Zachnad0/KICAD-ESP32-ZBoard-Mk-I/KICAD-ESP32-ZBoard-Mk-I.kicad_pcb

## KiCad design KICAD-ESP32-ZBoard-Mk-I.kicad_pcb (2025-09-27)

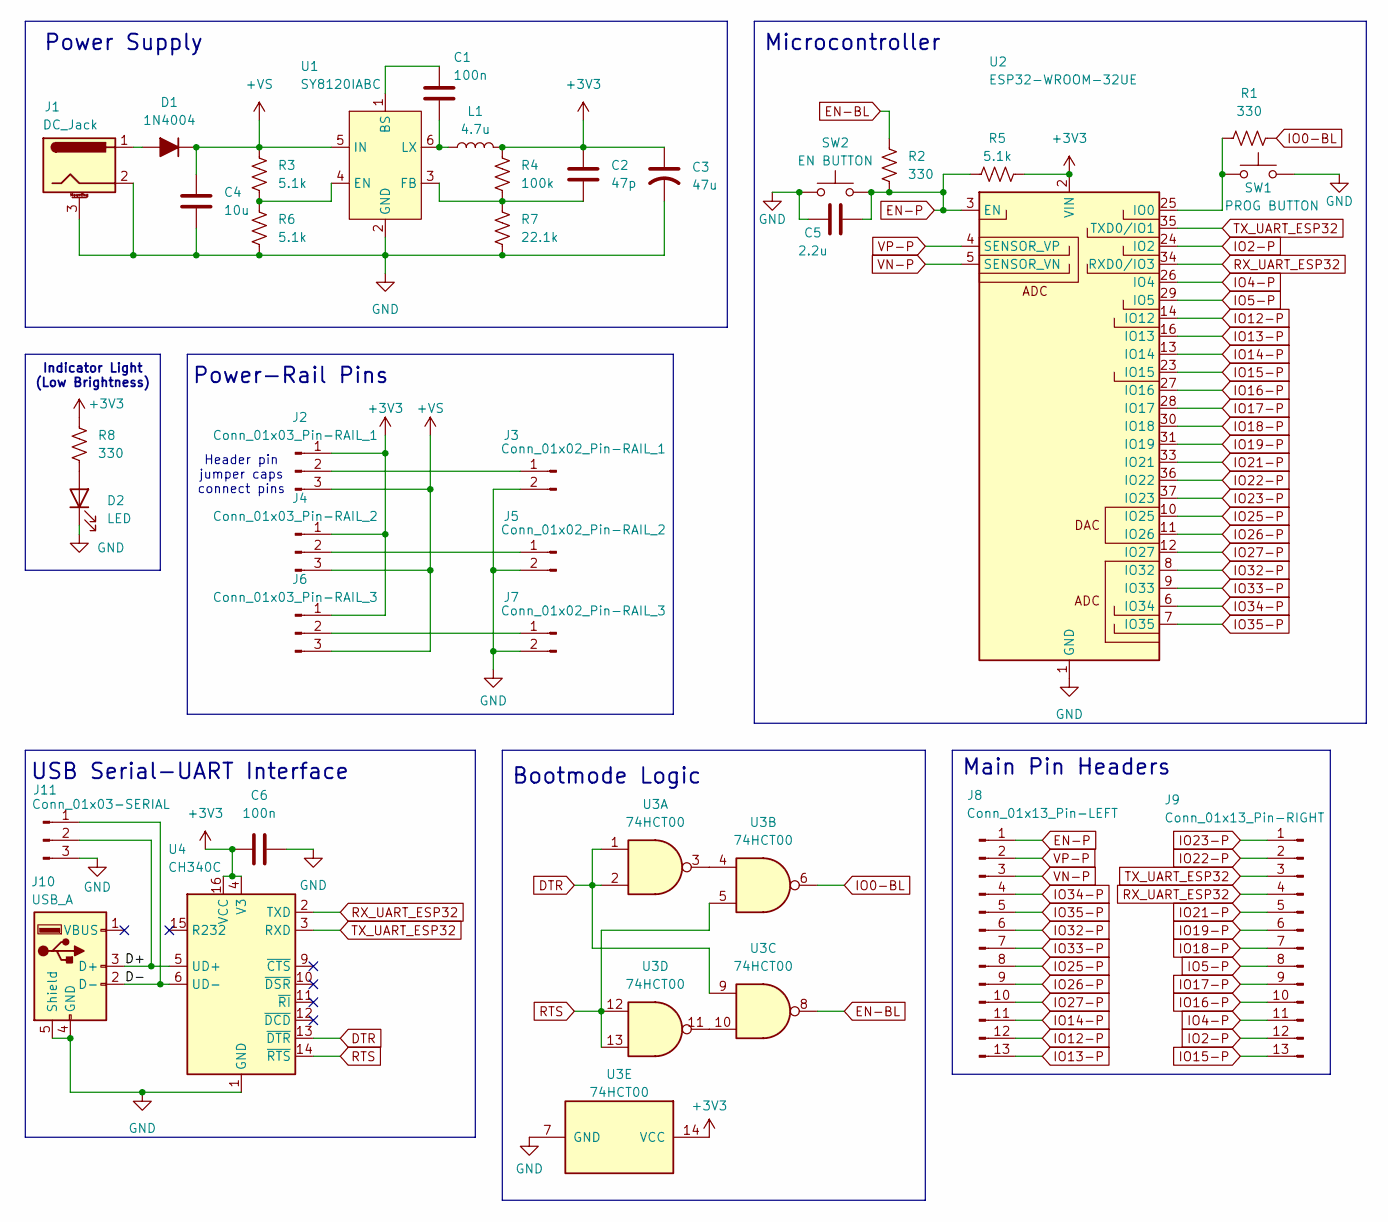
[picture p1: schematic KICAD-ESP32-ZBoard-Mk-I.kicad_sch, ZBoard Mk-I]

Parts:
C1, C6: 100n; C_1206_3216Metric_Pad1.33x1.80mm_HandSolder; LCSC Part # C97946
C2: 47p; C_0603_1608Metric_Pad1.08x0.95mm_HandSolder; LCSC Part # C882552
C3: 47u; CP_Radial_D5.0mm_P2.50mm; LCSC Part # n/a
C4: 10u; C_0805_2012Metric_Pad1.18x1.45mm_HandSolder; LCSC Part # C440198
C5: 2.2u; C_0603_1608Metric_Pad1.08x0.95mm_HandSolder; LCSC Part # C415535
D1: 1N4004; D_DO-41_SOD81_P7.62mm_Horizontal; LCSC Part # n/a
D2: LED; D_0603_1608Metric_Pad1.05x0.95mm_HandSolder; LCSC Part # C497928
J1: DC_Jack; BarrelJack_Horizontal; LCSC Part # C720557
J2: Conn_01x03_Pin-RAIL_1; PinHeader_1x03_P2.54mm_Vertical; LCSC Part # n/a
J3: Conn_01x02_Pin-RAIL_1; PinHeader_1x02_P2.54mm_Vertical; LCSC Part # n/a
J4: Conn_01x03_Pin-RAIL_2; PinHeader_1x03_P2.54mm_Vertical; LCSC Part # n/a
J5: Conn_01x02_Pin-RAIL_2; PinHeader_1x02_P2.54mm_Vertical; LCSC Part # n/a
J6: Conn_01x03_Pin-RAIL_3; PinHeader_1x03_P2.54mm_Vertical; LCSC Part # n/a
J7: Conn_01x02_Pin-RAIL_3; PinHeader_1x02_P2.54mm_Vertical; LCSC Part # n/a
J8: Conn_01x13_Pin-LEFT; PinHeader_1x13_P2.54mm_Vertical; LCSC Part # n/a
J9: Conn_01x13_Pin-RIGHT; PinHeader_1x13_P2.54mm_Vertical; LCSC Part # n/a
J10: USB_A; USB-A Jing (C42576); LCSC Part # C42576
J11: Conn_01x03-SERIAL; PinHeader_1x03_P2.54mm_Vertical
L1: 4.7u; L_TDK_SLF7045; LCSC Part # C136201
R1, R2, R8: 330; R_0603_1608Metric; LCSC Part # C384242
R3, R5, R6: 5.1k; R_0603_1608Metric; LCSC Part # C318133
R4: 100k; R_0603_1608Metric; LCSC Part # C25803
R7: 22.1k; R_0603_1608Metric; LCSC Part # C5382621
SW1: PROG BUTTON; SW_101-C-W_XKB; LCSC Part # C318938
SW2: EN BUTTON; SW_101-C-W_XKB; LCSC Part # C318938
U1: SY8120IABC; SOT-23-6; LCSC Part # C479076
U2: ESP32-WROOM-32UE; LCSC Part # C701344
U3: 74HCT00; DIP-14_W7.62mm; LCSC Part # n/a
U4: CH340C; SOP-16_3.9x9.9mm_P1.27mm; LCSC Part # C84681

Connections:
+3V3: C2.1, C3.1, C6.1, J2.1, J4.1, J6.1, L1.2, R4.2, R5.2, R8.1, U2.2 (VIN), U3.14 (VCC), U4.4 (V3), U4.16 (VCC)
+VS: C4.1, D1.1 (K), J2.3, J4.3, J6.3, R3.1, U1.5 (IN)
/D+: J10.3 (D+), J11.2, U4.5 (UD+)
/D-: J10.2 (D-), J11.1, U4.6 (UD-)
DTR: U3.1, U3.2, U3.9, U4.13 (~DTR)
EN-BL: R2.1, U3.8
EN-P: C5.1, J8.1, R2.2, R5.1, SW2.2, U2.3 (EN)
GND: C3.2, C4.2, C5.2, C6.2, D2.1 (K), J1.2, J1.3 (MountPin), J3.2, J5.2, J7.2, J10.4 (GND), J10.5 (Shield), J11.3, R6.2, R7.2, SW1.2, SW2.1, U1.2 (GND), U2.1 (GND), U2.15 (GND), U2.38 (GND), U2.39 (GND), U3.7 (GND), U4.1 (GND)
IO0-BL: R1.2, U3.6
IO2-P: J9.12, U2.24 (IO2)
IO4-P: J9.11, U2.26 (IO4)
IO5-P: J9.8, U2.29 (IO5)
IO12-P: J8.12, U2.14 (IO12)
IO13-P: J8.13, U2.16 (IO13)
IO14-P: J8.11, U2.13 (IO14)
IO15-P: J9.13, U2.23 (IO15)
IO16-P: J9.10, U2.27 (IO16)
IO17-P: J9.9, U2.28 (IO17)
IO18-P: J9.7, U2.30 (IO18)
IO19-P: J9.6, U2.31 (IO19)
IO21-P: J9.5, U2.33 (IO21)
IO22-P: J9.2, U2.36 (IO22)
IO23-P: J9.1, U2.37 (IO23)
IO25-P: J8.8, U2.10 (IO25)
IO26-P: J8.9, U2.11 (IO26)
IO27-P: J8.10, U2.12 (IO27)
IO32-P: J8.6, U2.8 (IO32)
IO33-P: J8.7, U2.9 (IO33)
IO34-P: J8.4, U2.6 (IO34)
IO35-P: J8.5, U2.7 (IO35)
unnamed: D1.2 (A), J1.1
unnamed: D2.2 (A), R8.2
unnamed: J2.2, J3.1
unnamed: J4.2, J5.1
unnamed: J6.2, J7.1
unnamed: C1.1, U1.1 (BS)
unnamed: R3.2, R6.1, U1.4 (EN)
unnamed: C2.2, R4.1, R7.1, U1.3 (FB)
unnamed: C1.2, L1.1, U1.6 (LX)
unnamed: R1.1, SW1.1, U2.25 (IO0)
unnamed: U3.3, U3.4
unnamed: U3.10, U3.11
RTS: U3.5, U3.12, U3.13, U4.14 (~RTS)
RX_UART_ESP32: J9.4, U2.34 (RXD0/IO3), U4.2 (TXD)
TX_UART_ESP32: J9.3, U2.35 (TXD0/IO1), U4.3 (RXD)
VN-P: J8.3, U2.5 (SENSOR_VN)
VP-P: J8.2, U2.4 (SENSOR_VP)

Notes on the sheet:
USB Serial-UART Interface
Indicator Light (Low Brightness)
Power Supply
Header pin jumper caps connect pins
Main Pin Headers
Bootmode Logic
Power-Rail Pins
Microcontroller

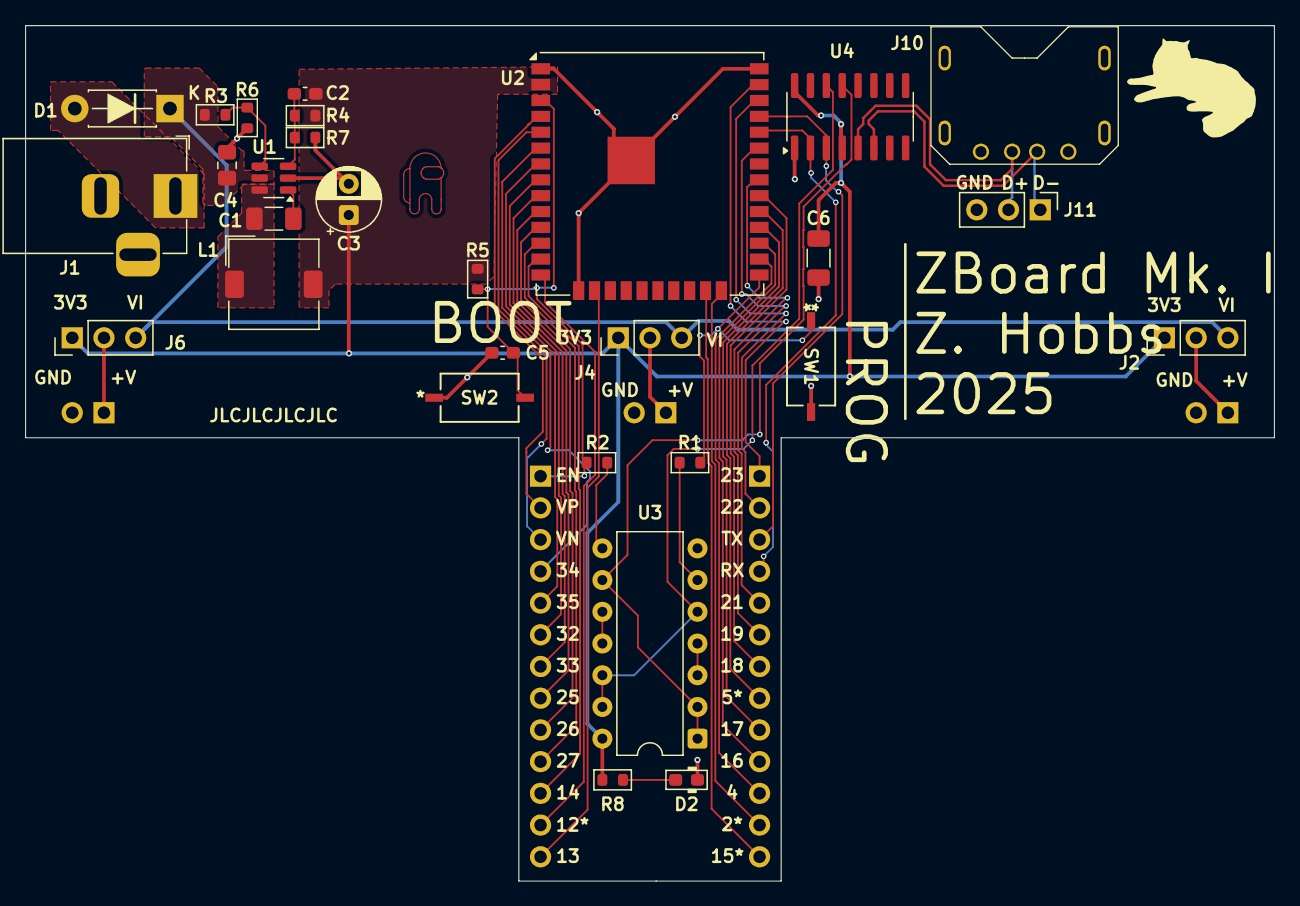
[picture p2: board KICAD-ESP32-ZBoard-Mk-I.kicad_pcb from above]

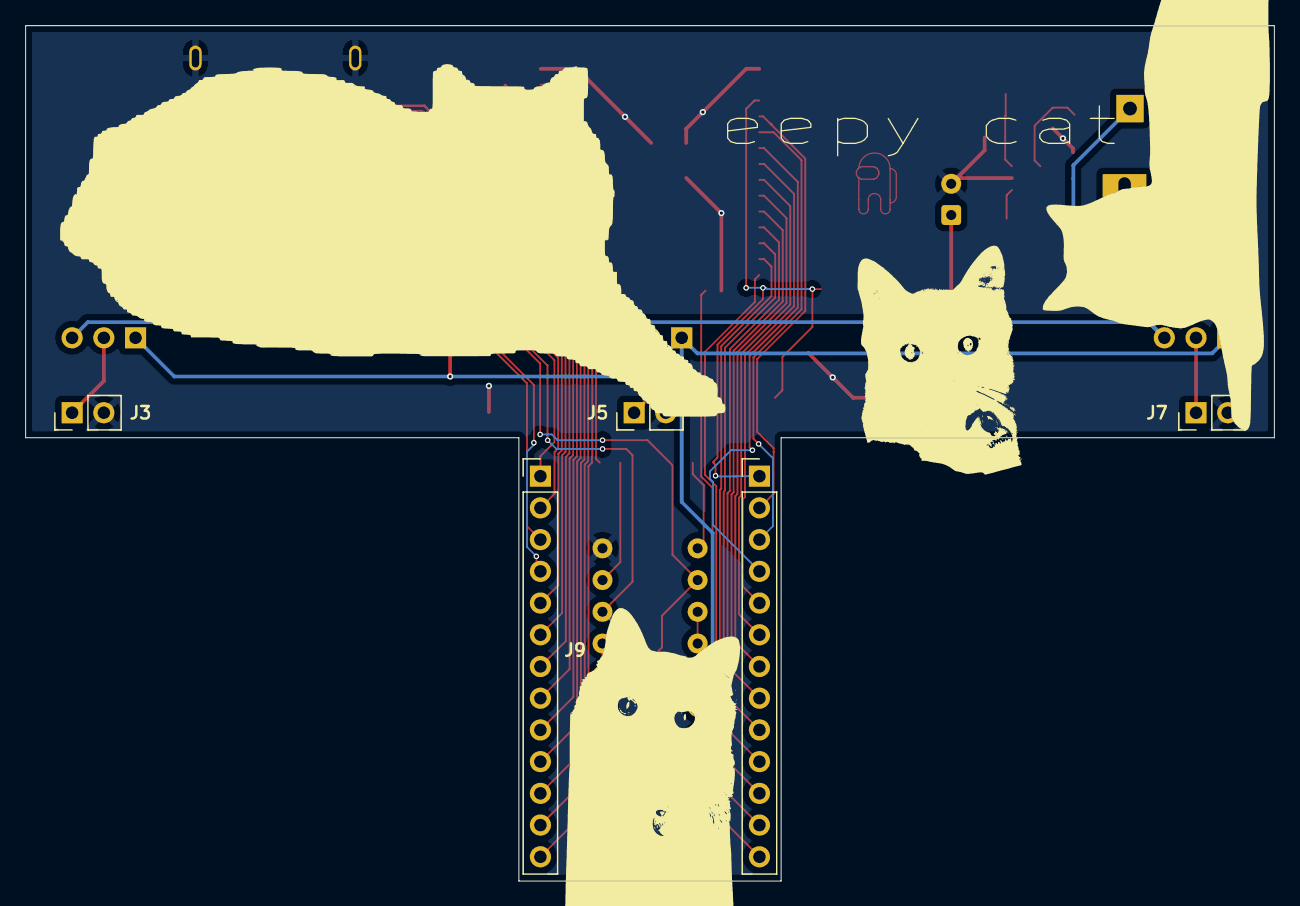
[picture p3: board KICAD-ESP32-ZBoard-Mk-I.kicad_pcb from below]

Board: 2 copper layers, 100.0 x 68.5 mm, 35 parts (5 on the bottom side), 47 nets.

Other parts of the board:
FluffGraphic2: LOGO; FluffGraphic2
