Zachnad0/KICAD-ESP32-ZBoard-Mk-I/(commit log)

2025-07-16 Initialized project files.
    [KICAD-ESP32-ZBoard-Mk-I.kicad_pcb, KICAD-ESP32-ZBoard-Mk-I.kicad_sch]
2025-07-26 ADDED most major ICs for DC power, USB-to-UART, and the ESP32 itself.
    [KICAD-ESP32-ZBoard-Mk-I.kicad_sch]
2025-08-19 ADDED power supply. ADDED indicator LED.
    [KICAD-ESP32-ZBoard-Mk-I.kicad_sch]
2025-08-20 ADDED boot mode control logic. ADDED power-rail selection pin headers.
    [KICAD-ESP32-ZBoard-Mk-I.kicad_sch]
2025-08-25 ADDED main GPIO header pins, each 01x13.
    [KICAD-ESP32-ZBoard-Mk-I.kicad_sch]
2025-08-27 ADDED all LCSC part numbers and footprint assignments.
    [KICAD-ESP32-ZBoard-Mk-I.kicad_sch]
2025-08-29 FINISHED footprint placement. ADDED all routes and planes. TODO finalize silkscreen and adding text and graphics.
    [KICAD-ESP32-ZBoard-Mk-I.kicad_pcb, KICAD-ESP32-ZBoard-Mk-I.kicad_sch]
2025-08-30 ADDED silkscreen text and graphics. FIXED designator text being too small. TODO add header pin labels (very important!).
    [KICAD-ESP32-ZBoard-Mk-I.kicad_pcb]
2025-08-31 ADDED all remaining pin labels. ADDED serial-breakout pins in case alternative USB is wanted.
    [KICAD-ESP32-ZBoard-Mk-I.kicad_pcb, KICAD-ESP32-ZBoard-Mk-I.kicad_sch]
2025-09-01 ADDED more cat graphics to increase PCB performance by 35%.
    [KICAD-ESP32-ZBoard-Mk-I.kicad_pcb]
2025-09-02 ADDED some text and finalized board.
    [KICAD-ESP32-ZBoard-Mk-I.kicad_pcb]
2025-09-27 Finalized PCB for order.
    [KICAD-ESP32-ZBoard-Mk-I.kicad_pcb]
2025-09-27 Generated BOM for assembly
    [KICAD-ESP32-ZBoard-Mk-I.kicad_sch]
